fl00/iot-airquality-platform/dashboard/README.md

# Dashboard

FastHTML web application: one card per sensor with live values, and a history chart per sensor.

| File | Role |
| :--- | :--- |
| `main.py` | Pages, history API, live stream to browsers (`/api/v1/stream`) |
| `stream_bridge.py` | Reads the ingestor event stream, keeps the latest state of each sensor |
| `influx_service.py` | History queries (InfluxQL); the list of time ranges |
| `aqi_engine.py` | Label, colour and advice for each AQI level |
| `static/js/stream.js` | Applies live events to the cards and badges |
| `static/js/chart.js` | History chart (uPlot) |

The dashboard has no MQTT or Protobuf dependency: it consumes the ingestor stream specified in the [root README](../README.md#data-contracts). The interface is in French.

## Behaviour

- **Sensor list.** A sensor appears when its first event arrives. Display names can be set in `SENSOR_METADATA` (`stream_bridge.py`); otherwise the device id is shown.
- **Status badge.** As reported by the node: "En ligne" (OK), "Préchauffage" (warming up), "Capteur manquant" (degraded), "Panne" (fault). "Hors ligne" after 30 s without an event.
- **AQI badge.** The level comes from the ingestor; the dashboard only maps it to a label.
- **Chart.** Stored history only: mean values per time bucket, reloaded every minute. Live values are not appended to the curve. An empty or failed query gives an empty chart.
- **Time ranges.** Defined once, in `TIMEFRAMES` (`influx_service.py`): 6 h (5 min buckets), 24 h (10 min), 7 days (30 min), 30 days (2 h), 1 year (1 day).
- **Missing CO2 sensor.** A CO2 value of 0 is displayed as "—".
- **Ingestor unreachable.** The bridge retries every 2 s and logs the outage once.

## HTTP routes

| Route | Content |
| :--- | :--- |
| `/` | Sensor cards |
| `/sensor/{id}` | Detail and chart |
| `/api/v1/sensor/{id}/history?range=6h\|24h\|7j\|30j\|1an` | Columnar JSON `[[ts],[co2],[temp],[hum],[pm25]]` |
| `/api/v1/stream` | Server-Sent Events, one JSON object per sample (at most 64 clients) |
| `/health` | Liveness and number of sensors seen |

## Run

```bash
pip install -r requirements.txt                                     # exact versions, on purpose
INFLUXDB_TOKEN=... python3 -m uvicorn main:app --host 127.0.0.1 --port 8000    # or `make run-dashboard` with a .env file
```
