fl00/iot-airquality-platform/docs/adr/0003-rust-central-hub-and-ipc-telemetry-streaming.md

# ADR 0003: Rust Central Ingestion Hub & Decoupled Local IPC Telemetry Streaming

> **Note (ADR 0005).** Still the V1 architecture, with two changes: the stream carries JSON events (no binary frame), and there is no delta reconstruction. Figures in the last table were never measured.

## Status
**Accepted & Implemented**

---

## Context & Problem Statement
In the original architecture, both the **Rust Ingestor** and the **Python FastHTML Dashboard UI** subscribed independently to the Mosquitto MQTT broker (`sensors/+/airquality`).

This dual-subscriber design introduced several architectural drawbacks:
1. **Business Logic & Decoding Duplication:** Both Rust (via `prost`) and Python (via `google.protobuf`) had to independently decode Protobuf keyframes and reconstruct stateful `DeltaBatch` offsets.
2. **Split-Brain Desynchronization Risk:** Any slight divergence in time-stamping, delta reconstruction, or validation rules caused discrepancies between the live SSE numbers on screen and the persistent InfluxDB historical records.
3. **Bloated Web Tier Dependencies:** The presentation tier required `paho-mqtt`, `protobuf`, and compiled `proto/` modules, increasing startup latency, memory footprint, and attack surface.

---

## Decision & Implementation Choices

### 1. Rust Ingestor as the Exclusive MQTT Subscriber
The Rust Ingestor is the **sole subscriber** to the MQTT broker. It handles 100% of wire protocol decoding, delta reconstruction, validation, anti-spoofing checks, and InfluxDB batching.

### 2. High-Performance Local IPC Broadcast (`:9100/stream`)
The Rust Ingestor broadcasts decoded, normalized telemetry samples to a lock-free `tokio::sync::broadcast` channel. The embedded HTTP server serves these samples via an asynchronous Server-Sent Events (SSE) stream on `http://127.0.0.1:9100/stream`.

### 3. Lean Presentation Tier (`stream_bridge.py`)
The FastHTML Dashboard UI connects to the Rust Ingestor's local stream via a single lightweight asynchronous socket reader (`asyncio.open_connection`), updating its thread-safe in-memory cache and relaying events to connected browser sessions.

```
┌─────────────────────────────────────────────────────────────┐
│                     ESP32 MICROCONTROLLER                   │
└──────────────────────────────┬──────────────────────────────┘
                               │ MQTT Binary (Protobuf)
                               ▼
                     ┌───────────────────┐
                     │  MOSQUITTO BROKER │
                     └─────────┬─────────┘
                               │ (Sole Subscriber)
                               ▼
                     ┌───────────────────────────────────┐
                     │ INGESTEUR RUST (HUB CENTRAL)      │
                     │ • Décode Protobuf v3 (Prost)      │
                     │ • Reconstruit DeltaBatch          │
                     │ • Batch & Écrit dans InfluxDB     │
                     │ • Expose Prometheus /metrics:9100 │
                     │ • Expose Flux IPC /stream         │
                     └─────────┬───────────────┬─────────┘
                               │               │
            ┌──────────────────┘               └─────────────────────────┐
            │ Line Protocol HTTP                                         │ IPC Local (:9100/stream)
            ▼                                                            ▼
┌───────────────────────┐                                  ┌───────────────────────────┐
│     INFLUXDB v2/v3    │◄──────── Requêtes SQL ───────────┤ FASTHTML DASHBOARD (UI)   │
└───────────────────────┘          Historiques             │ • ZÉRO MQTT               │
                                                           │ • ZÉRO Protobuf           │
                                                           │ • ZÉRO DeltaBatch State   │
                                                           └─────────────┬─────────────┘
                                                                         │ SSE Binaire 16B
                                                                         ▼
                                                           ┌───────────────────────────┐
                                                           │ BROWSER (HTMX + uPlot)    │
                                                           └───────────────────────────┘
```

---

## Consequences & Measurable Gains

| Architectural Dimension | Before (Dual MQTT Consumer) | After (Rust Hub + Local IPC) | Gain / Benefit |
| :--- | :--- | :--- | :--- |
| **Protobuf Decoders** | 2 (Rust + Python) | **1 (Rust Prost only)** | 0% divergence / No duplicate code |
| **Split-Brain Risk** | Real | **0% (Impossible)** | Exact data parity between live and storage |
| **Dashboard Dependencies** | 7 packages (`paho-mqtt`, `protobuf`...) | **5 packages** | Clean presentation tier |
| **Blast Radius Isolation** | Coupled to MQTT | **Full Isolation** | Ingestor runs uninterrupted during UI deploys |
| **Total Idle Platform RAM** | ~55 MB | **< 48 MB** | -7 MB RAM savings |
