fl00/iot-airquality-platform/hardware/enclosure/preview.png

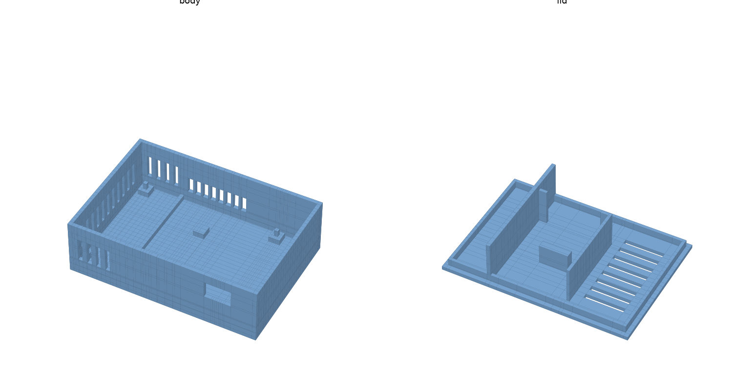
hardware/enclosure/preview.png
