fl00/iot-airquality-platform/hardware/enclosure/body.stl

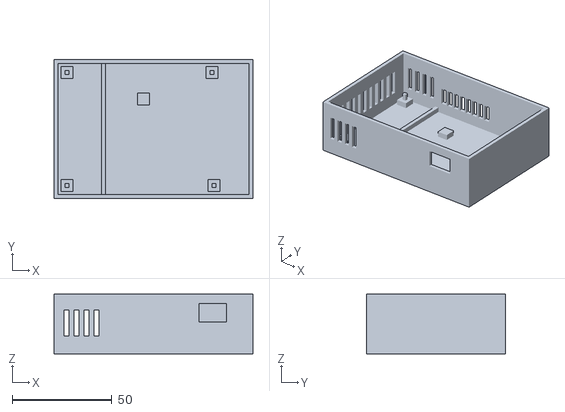
[picture p3: CAD file, 2026-11-12]
hardware/enclosure/body.stl
100.0 x 70.0 x 30.0
