fl00/iot-airquality-platform/hardware/enclosure/lid.stl

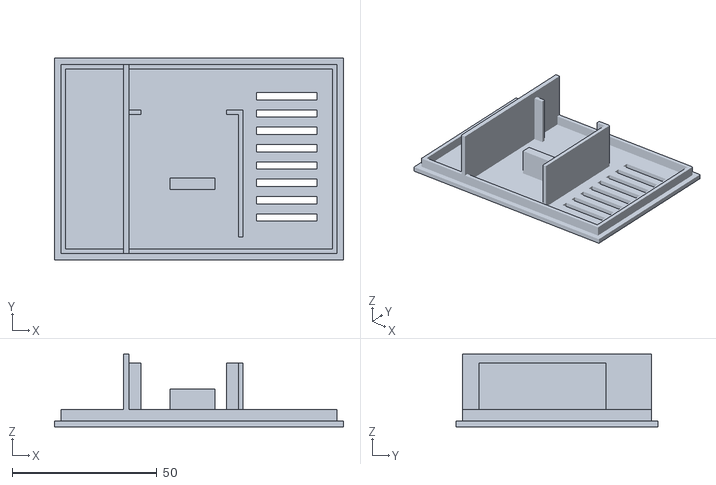
[picture p4: CAD file, 2026-11-12]
hardware/enclosure/lid.stl
100.0 x 70.0 x 25.1
