fl00/iot-airquality-platform/hardware/enclosure/enclosure.scad

// Generated by enclosure.py - edit the parameters there, or tweak the boxes here.
// Outer size: 100 x 70 x 32 mm

module body() {
difference() {
difference() {
difference() {
difference() {
difference() {
difference() {
difference() {
difference() {
difference() {
difference() {
difference() {
difference() {
difference() {
difference() {
difference() {
difference() {
difference() {
difference() {
difference() {
difference() {
difference() {
difference() {
difference() {
difference() {
difference() {
difference() {
difference() {
difference() {
union() {
union() {
union() {
union() {
union() {
union() {
union() {
union() {
union() {
union() {
difference() {
translate([0,0,0]) cube([100,70,30]);
translate([2,2,2]) cube([96,66,29]);
}
translate([3.5,3.5,2]) cube([6,6,3]);
}
translate([5.5,5.5,2]) cube([2,2,6.6]);
}
translate([3.5,60.5,2]) cube([6,6,3]);
}
translate([5.5,62.5,2]) cube([2,2,6.6]);
}
translate([76.5,60.5,2]) cube([6,6,3]);
}
translate([78.5,62.5,2]) cube([2,2,6.6]);
}
translate([77.4,3.5,2]) cube([6,6,3]);
}
translate([79.4,5.5,2]) cube([2,2,6.6]);
}
translate([42,47,2]) cube([6,6,3]);
}
translate([23.8,2,2]) cube([2,66,2.7]);
}
translate([-1,8,9]) cube([3.5,2.5,13]);
}
translate([-1,13,9]) cube([3.5,2.5,13]);
}
translate([-1,18,9]) cube([3.5,2.5,13]);
}
translate([-1,23,9]) cube([3.5,2.5,13]);
}
translate([-1,28,9]) cube([3.5,2.5,13]);
}
translate([-1,33,9]) cube([3.5,2.5,13]);
}
translate([-1,38,9]) cube([3.5,2.5,13]);
}
translate([-1,43,9]) cube([3.5,2.5,13]);
}
translate([-1,48,9]) cube([3.5,2.5,13]);
}
translate([-1,53,9]) cube([3.5,2.5,13]);
}
translate([-1,58,9]) cube([3.5,2.5,13]);
}
translate([5,-1,9]) cube([2.5,3.5,13]);
}
translate([5,67.5,9]) cube([2.5,3.5,13]);
}
translate([10,-1,9]) cube([2.5,3.5,13]);
}
translate([10,67.5,9]) cube([2.5,3.5,13]);
}
translate([15,-1,9]) cube([2.5,3.5,13]);
}
translate([15,67.5,9]) cube([2.5,3.5,13]);
}
translate([20,-1,9]) cube([2.5,3.5,13]);
}
translate([20,67.5,9]) cube([2.5,3.5,13]);
}
translate([28,67.5,8.1]) cube([3,3.5,9]);
}
translate([32.2,67.5,8.1]) cube([3,3.5,9]);
}
translate([36.4,67.5,8.1]) cube([3,3.5,9]);
}
translate([40.6,67.5,8.1]) cube([3,3.5,9]);
}
translate([44.8,67.5,8.1]) cube([3,3.5,9]);
}
translate([49,67.5,8.1]) cube([3,3.5,9]);
}
translate([53.2,67.5,8.1]) cube([3,3.5,9]);
}
translate([57.4,67.5,8.1]) cube([3,3.5,9]);
}
translate([72.8,-1,16]) cube([14,3.5,9.2]);
}
}

module lid() {
difference() {
difference() {
difference() {
difference() {
difference() {
difference() {
difference() {
difference() {
union() {
union() {
union() {
union() {
union() {
difference() {
union() {
translate([0,0,0]) cube([100,70,2]);
translate([2.25,2.25,2]) cube([95.5,65.5,4]);
}
translate([3.85,3.85,2]) cube([92.3,62.3,5]);
}
translate([23.8,2.25,2]) cube([2,65.5,23.1]);
}
translate([40,24.4,2]) cube([15.6,4,11]);
}
translate([63.6,8,2]) cube([1.6,44,20]);
}
translate([25.8,50.4,2]) cube([4.2,1.6,20]);
}
translate([59.6,50.4,2]) cube([5.6,1.6,20]);
}
translate([69.9,55.5,-1]) cube([21,2.5,3.5]);
}
translate([69.9,49.5,-1]) cube([21,2.5,3.5]);
}
translate([69.9,43.5,-1]) cube([21,2.5,3.5]);
}
translate([69.9,37.5,-1]) cube([21,2.5,3.5]);
}
translate([69.9,31.5,-1]) cube([21,2.5,3.5]);
}
translate([69.9,25.5,-1]) cube([21,2.5,3.5]);
}
translate([69.9,19.5,-1]) cube([21,2.5,3.5]);
}
translate([69.9,13.5,-1]) cube([21,2.5,3.5]);
}
}

body();
translate([0, 80, 0]) lid();
