fl00/iot-airquality-platform/(commit log)

2026-08-19 perf(css): add GPU hardware compositing and strict containment on sensor cards and chart wrapper
2026-08-20 fix(ui): fix HTMX 2.x after-request event binding on timeframe buttons and enable NaN gap handling in uPlot
2026-08-20 fix(ui): implement robust direct window.fetchTimeframe and explicit uPlot X-axis setScale
2026-11-12 feat(hardware): add ESP32 sensor node (BME680, SCD41, PMS7003)
    Firmware:
    - Rewrite main.cpp for real sensors: BSEC (BME680), SCD41 driver,
    PMS7003 parser, NTP time, non-blocking loop, 5 s FullSample keyframes
    - Add config.h (pins, cadences), secrets.example.h, telemetry.h
    - Complete the hand-written Nanopb header and add air_quality.options
    - Fix platformio.ini: 4 MB partition, drop obsolete LittleFS dependency,
    esp32dev-mock environment (remove the -U flag that broke include paths)
    - Add host-side test (firmware/test_host) for parsers and encoding
    Platform:
    - Recalibrate VOC thresholds to the BSEC breath-VOC scale in the
    ingestor and dashboard, update the air quality guides
    Hardware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
2026-11-12 fix: stop inventing, misattributing and losing measurements
    Data integrity (dashboard):
    - Return an empty history instead of synthetic curves when InfluxDB has
    no data or is unreachable
    - Replace the 16-byte binary live frame by the ingestor JSON stream: the
    4-bit sensor index and its four hard-coded lookup tables mapped unknown
    or non-numbered devices onto the wrong sensor
    Data loss (ingestor):
    - Keep samples in memory (up to 5000) when an InfluxDB write fails and
    retry on the flush timer, instead of discarding the batch
    - Reject packets with an invalid device id or non-finite values before
    they reach the line protocol and poison a whole batch
    - Flush the pending batch on SIGTERM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
2026-11-12 refactor: one simple, tested path from sensor to chart for V1
    Wire contract:
    - One complete sample per packet. Delta batches are removed (never
    emitted, untested, stateful); field 8 is reserved for a later return
    - Regenerate Python bindings, update Nanopb and Prost bindings
    Ingestor:
    - Remove the circuit breaker, the single-implementation sink trait and
    the dead build script; the retry buffer covers InfluxDB outages
    - Do not store CO2 or pressure when a node reports 0 (missing sensor)
    - Device ids limited to 31 characters, as in the contract
    - Expose iot_influx_buffered_samples; add unit tests
    - Commit Cargo.lock for reproducible builds
    Dashboard:
    - Show the status reported by the nod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
2026-11-12 docs: align the specification with the V1 implementation
    - README: architecture, the three data contracts, behaviour on failure,
    configuration, tests, security and known limits, each stated once
    - ADR 0005: V1 scope, why delta batches and the binary live frame are
    deferred, and what would justify each deferred optimisation
    - V1_VALIDATION: commissioning steps, fault checks, weekly indicators,
    exit criteria and feedback log
    - Component READMEs rewritten from the code; unmeasured benchmark
    figures removed; earlier ADRs annotated instead of rewritten
2026-11-12 refactor: remove what V1 does not need from ingestor, dashboard and tooling
    Reliability:
    - Chart shows stored history only and reloads every minute. Live samples
    are no longer appended to the curve: replayed packets arrive out of
    order and broke the plot
    - Pin exact dashboard dependency versions
    - Invalid environment values stop the ingestor instead of silently
    falling back to defaults; a busy HTTP port stops it as well
    - Dashboard logs when the ingestor stream is lost, once per outage
    Simplification:
    - Ingestor: drop METRICS_ENABLED, MQTT_TOPIC and MQTT_CLIENT_ID, the
    unused /health route, the TLS features (two rustls stacks) and anyhow;
    table-driven metrics, one function per HTT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
2026-11-12 feat: make the validation period observable
    - Daily health report (systemd timer): one CSV line per node with
    completeness, packets lost, node reboots, ingestor counters, disk and
    service restarts; alert when a node is silent, completeness drops,
    InfluxDB writes fail or the disk fills up. Alerts are POSTed to
    ALERT_URL when set
    - Store the packet sequence number (seq): gaps measure packet loss,
    resets reveal node reboots
    - Firmware: reboot after 15 minutes without Wi-Fi, saving the BSEC
    calibration first; the offline queue and the clock survive
    - End-to-end test now runs against a private, temporary InfluxDB
    instance instead of a recorder, and covers the outage and recovery
    p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
2026-11-12 feat: transmit and store the BSEC IAQ index and its calibration state
    The VOC thresholds rest on two published BSEC readings. Two diagnostic
    fields (static_iaq, iaq_accuracy) are added to the wire contract and
    stored in InfluxDB (iaq, iaq_accuracy) so the thresholds can be checked
    on real sensors at the end of the validation period. They are not
    displayed and do not affect the AQI level.
    A packet grows from about 64 to about 70 bytes; the offline queue holds
    about 10 hours instead of 11. The validation guide gains the threshold
    check procedure.
    Claude-Session: https://claude.ai/code/session_01Gqex5peVm3P2f56nAHKfZ6
2026-11-12 docs: host the platform on a Mac in an Ubuntu VM; fix InfluxDB repo key
    - deploy/MACOS_VM.md: VirtualBox, NAT with port forwarding (1883, and
    8080 for the dashboard), headless start at login, sleep settings,
    checks from the LAN and daily commands
    - deploy-baremetal.sh: use the current InfluxData signing key. The
    "_compat" key expired on 2026-01-17, so the InfluxDB installation
    would have failed
    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
2026-11-12 fix(hardware): enclosure USB opening height and peg size; pre-order checks
    Design review of the carrier PCB and the enclosure:
    - Enclosure: the USB opening ignored the plastic body of the ESP32 pin
    headers (2.5 mm), so a plug overmould would have hit the top of the
    opening. The opening now spans 16 to 25 mm
    - Enclosure: square pegs reduced from 2.2 to 2.0 mm. A 2.2 mm square has
    a 3.1 mm diagonal, with no print tolerance left in a 3.2 mm hole
    - Gerbers read back with a third-party parser (gerbonara): layers,
    outline and drill counts match the generator
    - hardware/README: list of the measurements to take on the real parts
    before ordering the board (module length against the lid par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
